evabits/EMI_sniffer_beursgadget_WOTS_2026/README.md

Here you will find the complete source documentation of the EMI sniffer after WOTS2026.
