evabits/EMI_sniffer_beursgadget_WOTS_2026/Design/EMIsniffer.kicad_pcb

## KiCad design Design/EMIsniffer.kicad_pcb (2026-09-25)

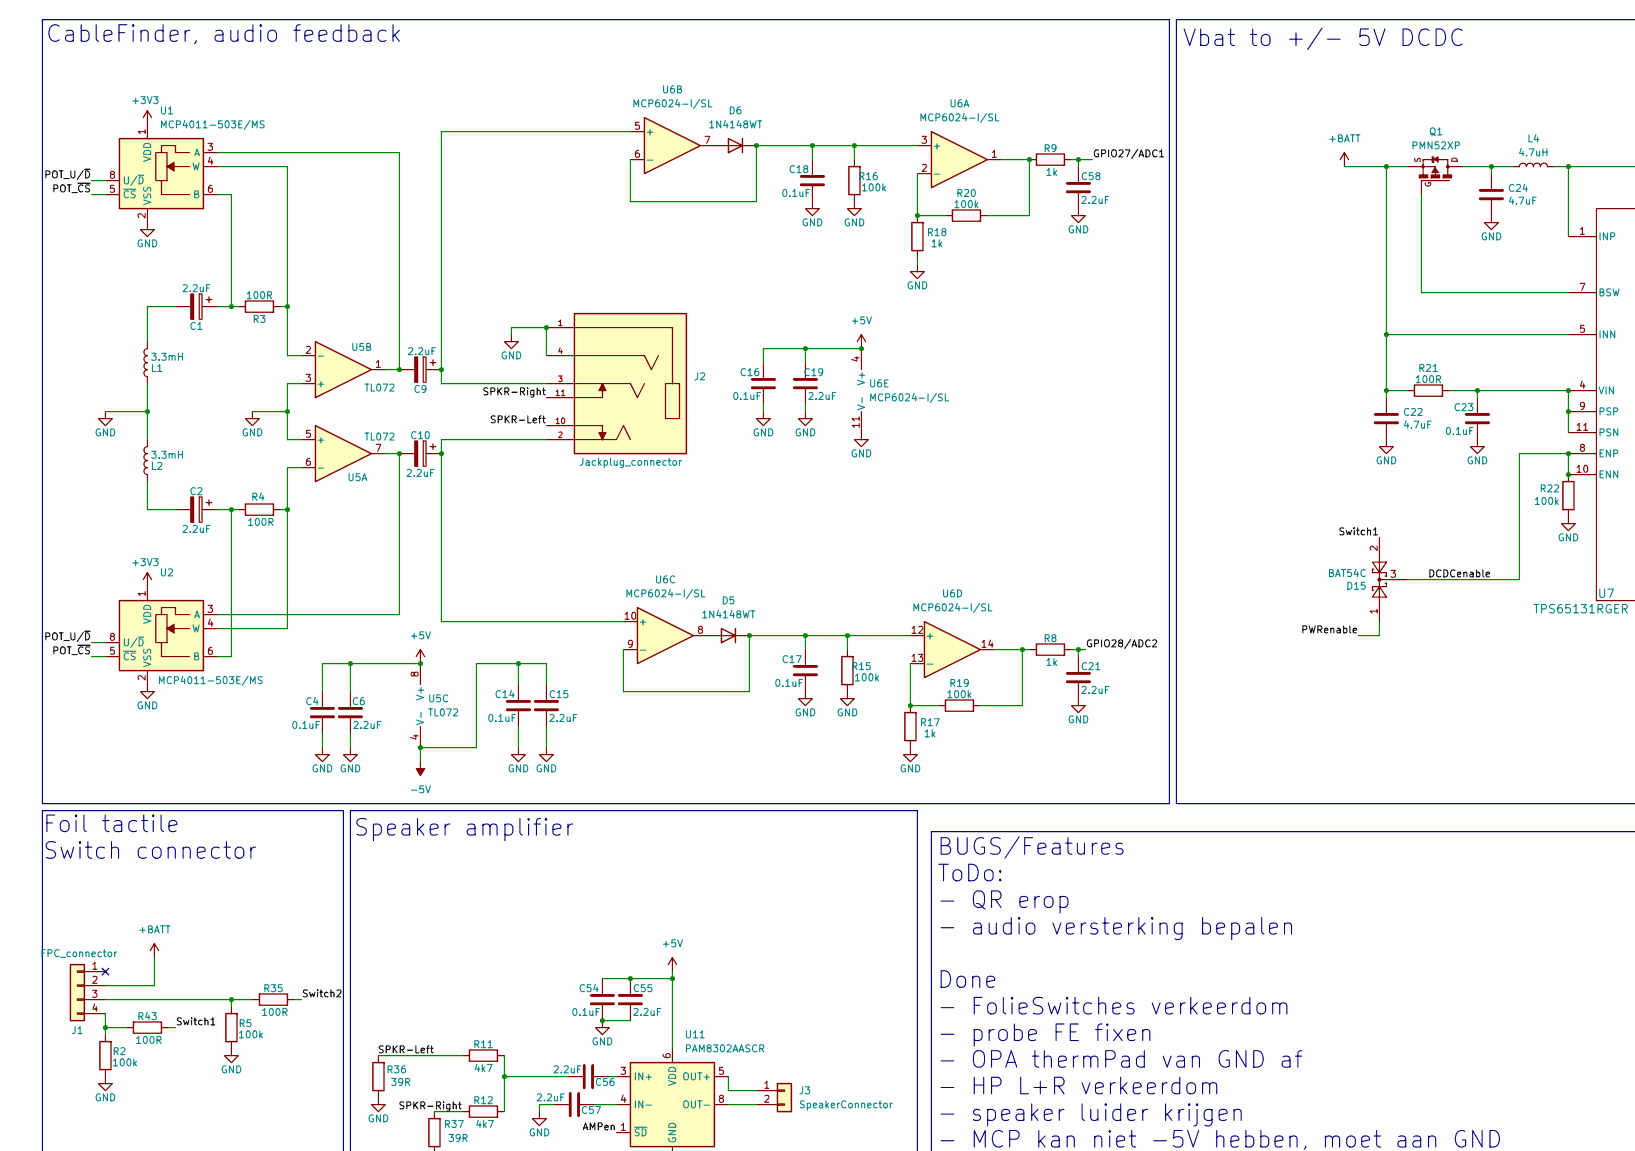
[picture p1: schematic EMIsniffer.kicad_sch, EMIsniffer (WoTS gadget 2026), part in row 1, column 1]

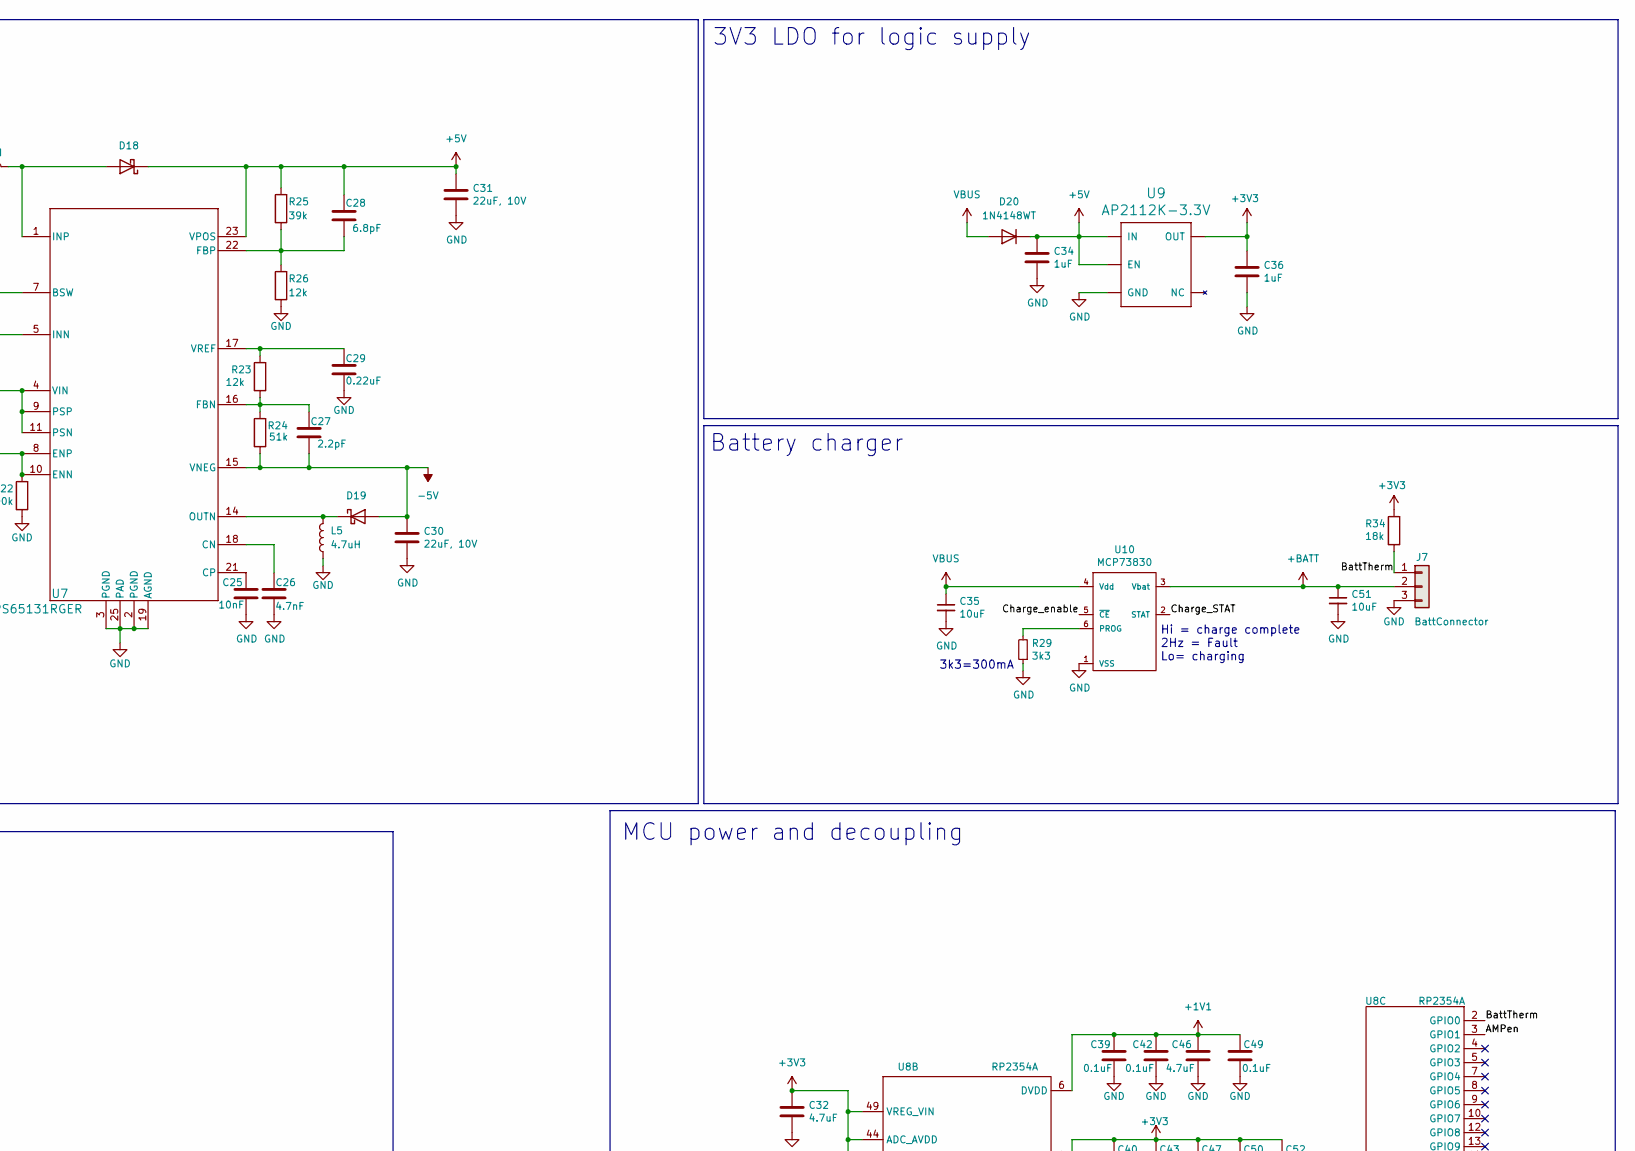
[picture p2: schematic EMIsniffer.kicad_sch, EMIsniffer (WoTS gadget 2026), part in row 1, column 2]

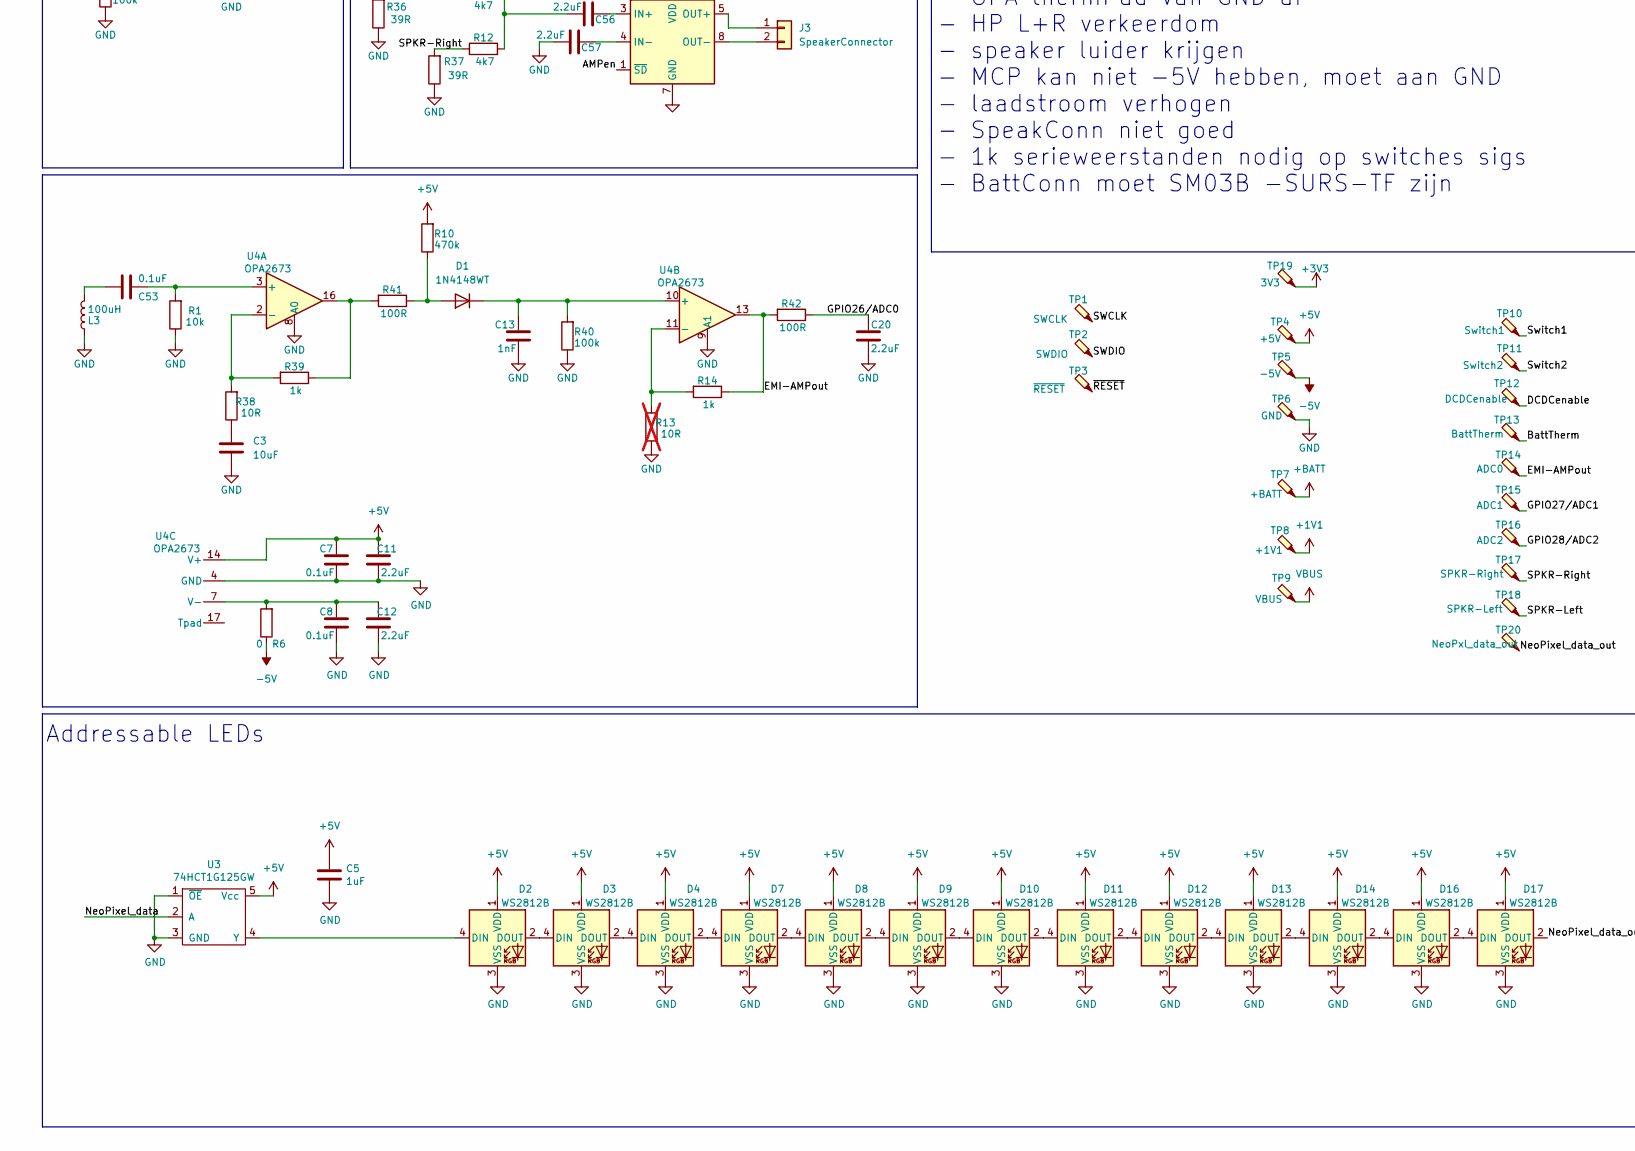
[picture p3: schematic EMIsniffer.kicad_sch, EMIsniffer (WoTS gadget 2026), part in row 2, column 1]

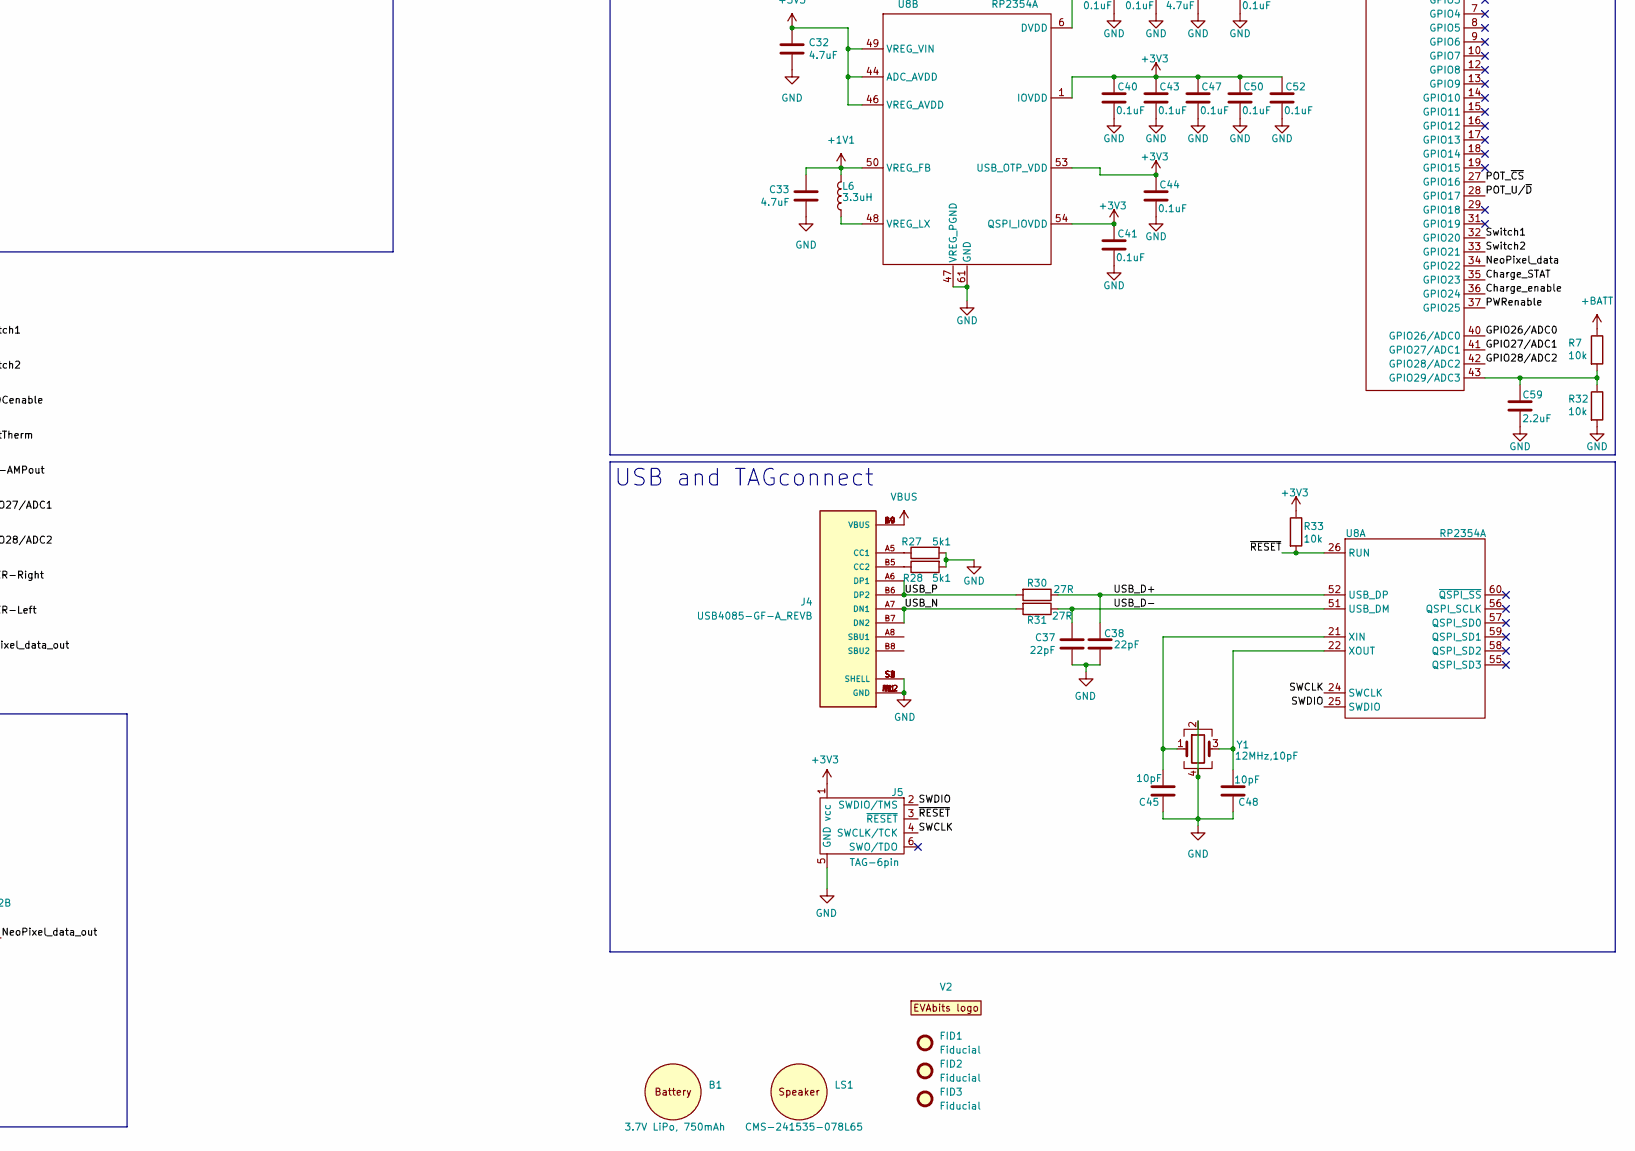
[picture p4: schematic EMIsniffer.kicad_sch, EMIsniffer (WoTS gadget 2026), part in row 2, column 2]

Parts:
B1: 3.7V LiPo, 750mAh; place_marker; Partnumber DJ343650
C1, C2, C9, C10: 2.2uF; C_Elec_4x5.4; Partnumber 865090540001
C3, C35, C51: 10uF; C_0805_2012Metric
C4, C7, C8, C14, C16, C17, C18, C23, C39, C40, C41, C42, C43, C44, C47, C49, C50, C52, C53, C54: 0.1uF; C_0402_1005Metric
C5, C34, C36: 1uF; C_0603_1608Metric
C6, C11, C12, C15, C19, C20, C21, C55, C56, C57, C58, C59: 2.2uF; C_0603_1608Metric
C13: 1nF; C_0402_1005Metric
C22, C24, C32, C33, C46: 4.7uF; C_0603_1608Metric
C25: 10nF; C_0402_1005Metric
C26: 4.7nF; C_0402_1005Metric
C27: 2.2pF; C_0402_1005Metric
C28: 6.8pF; C_0402_1005Metric
C29: 0.22uF; C_0402_1005Metric
C30, C31: 22uF, 10V; C_1206_3216Metric
C37, C38: 22pF; C_0402_1005Metric
C45, C48: 10pF; C_0402_1005Metric
D1, D5, D6, D20: 1N4148WT; D_SOD-523; Partnumber 1N4148WT
D2, D3, D4, D7, D8, D9, D10, D11, D12, D13, D14, D16, D17: WS2812B; LED_WS2812B_PLCC4_5.0x5.0mm_P3.2mm; Partnumber 1315050930002
D15: BAT54C; SOT-23; Partnumber BAT54C
D18, D19: SK12; D_SMA; Partnumber SK12
FID1, FID2, FID3: Fiducial; Fiducial_1.5mm_Mask3mm
J1: FPC_connector; TE_84952-4_1x04-1MP_P1.0mm_Horizontal; Partnumber TE_84952-4
J2: Jackplug_connector; CUI_SJ2-35954D-SMT-TR; PARTREV 1.04
J3: SpeakerConnector; Molex_PicoBlade_53398-0271_1x02-1MP_P1.25mm_Vertical; Partnumber 0533980271
J4: USB4085-GF-A_REVB; GCT_USB4085-GF-A_REVB; PARTREV B
J5: TAG-6pin; Tag-Connect_TC2030-IDC-NL_2x03_P1.27mm_Vertical; Partnumber DNP
J7: BattConnector; JST_SUR_SM03B-SURS-TF_1x03-1MP_P0.80mm_Horizontal; Partnumber SM03B -SURS-TF
L1, L2: 3.3mH; L_Wurth_WE-TI-8095; Partnumber 7447720332
L3: 100uH; IND_LQH2HNH_03_MUR; Partnumber LQH2HNH101J03L
L4, L5: 4.7uH; L_Taiyo-Yuden_NR-40xx_HandSoldering; Partnumber NRS4018T4R7MDGJ
L6: 3.3uH; L_Wuerth_PMCI-201610; Partnumber AOTA-B201610S3R3-101-T
LS1: CMS-241535-078L65; place_marker; Partnumber CMS-241535-078L65
Q1: PMN52XP; TSOP-6_1.65x3.05mm_P0.95mm; Partnumber PMN52XP
R1, R7, R32, R33: 10k; R_0603_1608Metric
R2, R5, R15, R16, R19, R20, R22, R40: 100k; R_0603_1608Metric
R3, R4, R21, R35, R41, R42, R43: 100R; R_0603_1608Metric
R6: 0; R_0603_1608Metric
R8, R9, R14, R17, R18, R39: 1k; R_0603_1608Metric
R10: 470k; R_0603_1608Metric
R11, R12: 4k7; R_0603_1608Metric
R13: 10R; R_0603_1608Metric; not fitted
R23, R26: 12k; R_0603_1608Metric
R24: 51k; R_0603_1608Metric
R25: 39k; R_0603_1608Metric
R27, R28: 5k1; R_0603_1608Metric
R29: 3k3; R_0603_1608Metric
R30, R31: 27R; R_0603_1608Metric
R34: 18k; R_0603_1608Metric
R36, R37: 39R; R_0603_1608Metric
R38: 10R; R_0603_1608Metric
TP1: SWCLK; TestPoint_Pad_D1.5mm; Partnumber DNP
TP2: SWDIO; TestPoint_Pad_D1.5mm; Partnumber DNP
TP3: ~{RESET}; TestPoint_Pad_D1.5mm; Partnumber DNP
TP4: +5V; TestPoint_Pad_D1.5mm; Partnumber DNP
TP5: -5V; TestPoint_Pad_D1.5mm; Partnumber DNP
TP6: GND; TestPoint_Pad_D1.5mm; Partnumber DNP
TP7: +BATT; TestPoint_Pad_D1.5mm; Partnumber DNP
TP8: +1V1; TestPoint_Pad_D1.5mm; Partnumber DNP
TP9: VBUS; TestPoint_Pad_D1.5mm; Partnumber DNP
TP10: Switch1; TestPoint_Pad_D1.5mm; Partnumber DNP
TP11: Switch2; TestPoint_Pad_D1.5mm; Partnumber DNP
TP12: DCDCenable; TestPoint_Pad_D1.5mm; Partnumber DNP
TP13: BattTherm; TestPoint_Pad_D1.5mm; Partnumber DNP
TP14: ADC0; TestPoint_Pad_D1.5mm; Partnumber DNP
TP15: ADC1; TestPoint_Pad_D1.5mm; Partnumber DNP
TP16: ADC2; TestPoint_Pad_D1.5mm; Partnumber DNP
TP17: SPKR-Right; TestPoint_Pad_D1.5mm; Partnumber DNP
TP18: SPKR-Left; TestPoint_Pad_D1.5mm; Partnumber DNP
TP19: 3V3; TestPoint_Pad_D1.5mm; Partnumber DNP
TP20: NeoPxl_data_out; TestPoint_Pad_D1.5mm; Partnumber DNP
U1, U2: MCP4011-503E/MS; MSOP-8_3x3mm_P0.65mm; Partnumber MCP4011-503E/MS
U3: 74HCT1G125GW; SOT-353_SC-70-5; Partnumber 74HCT1G125GW
U4: OPA2673; QFN-16-1EP_4x4mm_P0.65mm_EP2.1x2.1mm; Partnumber OPA2673IRGVR
U5: TL072; SO-8_3.9x4.9mm_P1.27mm; Partnumber TL072
U6: MCP6024-I/SL; SOIC-14_3.9x8.7mm_P1.27mm; Partnumber MCP6024-I/SL
U7: TPS65131RGER; VQFN-24-1EP_4x4mm_P0.5mm_EP2.5x2.5mm; Partnumber TPS65131-Q1
U8: RP2354A; QFN-60-1EP_7x7mm_P0.4mm_EP3.4x3.4mm; Partnumber RP2354A
U9: AP2112K-3.3V; TSOT-23-5; Partnumber AP2112K-3.3
U10: MCP73830; DFN-6-1EP_2x2mm_P0.5mm_EP0.61x1.42mm; Partnumber MCP73830T-2AAI/MYY
U11: PAM8302AASCR; MSOP-8_3x3mm_P0.65mm; Partnumber PAM8302AASCR
V2: EVAbits_logo; EVAbits_newlogo 25x6mm
Y1: 12MHz,10pF; Crystal_SMD_3225-4Pin_3.2x2.5mm; Partnumber NX3225SA-12MHZ-STD-CSR-6

Connections:
+1V1: C33.2, C39.1, C42.1, C46.2, C49.1, L6.1, TP8.1, U8.6 (DVDD), U8.23 (DVDD), U8.39 (DVDD), U8.50 (VREG_FB)
+3V3: C32.2, C36.2, C40.1, C41.1, C43.1, C44.1, C47.1, C50.1, C52.1, J5.1 (vcc), R33.1, R34.1, TP19.1, U1.1 (VDD), U2.1 (VDD), U8.1 (IOVDD), U8.11 (IOVDD), U8.20 (IOVDD), U8.30 (IOVDD), U8.38 (IOVDD), U8.44 (ADC_AVDD), U8.45 (IOVDD), U8.46 (VREG_AVDD), U8.49 (VREG_VIN), U8.53 (USB_OTP_VDD), U8.54 (QSPI_IOVDD), U9.5 (OUT)
+5V: C4.1, C5.2, C6.2, C7.1, C11.2, C16.1, C19.2, C28.1, C31.2, C34.2, C54.1, C55.2, D2.1 (VDD), D3.1 (VDD), D4.1 (VDD), D7.1 (VDD), D8.1 (VDD), D9.1 (VDD), D10.1 (VDD), D11.1 (VDD), D12.1 (VDD), D13.1 (VDD), D14.1 (VDD), D16.1 (VDD), D17.1 (VDD), D18.1 (K), D20.1 (K), R10.2, R25.1, TP4.1, U3.5 (Vcc), U4.14 (V+), U5.8 (V+), U6.4 (V+), U7.23 (VPOS), U9.1 (IN), U9.3 (EN), U11.6 (VDD)
+BATT: C22.2, C51.1, J1.2, J7.2, Q1.4 (S), R7.1, R21.1, TP7.1, U7.5 (INN), U7.6 (INN), U10.3 (Vbat)
-5V: C14.1, C15.2, C27.2, C30.2, D19.2 (A), R6.1, R24.2, TP5.1, U5.4 (V-), U7.15 (VNEG)
/AMPen: U8.3 (GPIO1), U11.1 (~SD)
/BattTherm: J7.1, R34.2, TP13.1, U8.2 (GPIO0)
/Charge_STAT: U8.35 (GPIO23), U10.2 (STAT)
/Charge_enable: U8.36 (GPIO24), U10.5 (~CE)
/DCDCenable: D15.3, R22.1, TP12.1, U7.8 (ENP), U7.10 (ENN)
/EMI-AMPout: R14.1, R42.2, TP14.1, U4.13
/GPIO26/ADC0: C20.2, R42.1, U8.40 (GPIO26/ADC0)
/GPIO27/ADC1: C58.2, R9.2, TP15.1, U8.41 (GPIO27/ADC1)
/GPIO28/ADC2: C21.2, R8.2, TP16.1, U8.42 (GPIO28/ADC2)
/NeoPixel_data: U3.2 (A), U8.34 (GPIO22)
/NeoPixel_data_out: D17.2 (DOUT), TP20.1
/POT_U/~D: U1.8 (U/~D), U2.8 (U/~D), U8.28 (GPIO17)
/POT_~CS: U1.5 (~CS), U2.5 (~CS), U8.27 (GPIO16)
/PWRenable: D15.1, U8.37 (GPIO25)
/SPKR-Left: J2.10, R11.1, R36.2, TP18.1
/SPKR-Right: J2.11, R12.1, R37.2, TP17.1
/SWCLK: J5.4 (SWCLK/TCK), TP1.1, U8.24 (SWCLK)
/SWDIO: J5.2 (SWDIO/TMS), TP2.1, U8.25 (SWDIO)
/Switch1: D15.2, R43.1, TP10.1, U8.32 (GPIO20)
/Switch2: R35.1, TP11.1, U8.33 (GPIO21)
/USB_D+: C38.2, R30.1, U8.52 (USB_DP)
/USB_D-: C37.1, R31.1, U8.51 (USB_DM)
/USB_N: J4.A7 (DN1), J4.B7 (DN2), R31.2
/USB_P: J4.A6 (DP1), J4.B6 (DP2), R30.2
/~RESET: J5.3 (~RESET), R33.2, TP3.1, U8.26 (RUN)
GND: C3.2, C4.2, C5.1, C6.1, C7.2, C8.2, C11.1, C12.1, C13.2, C14.2, C15.1, C16.2, C17.2, C18.2, C19.1, C20.1, C21.1, C22.1, C23.2, C24.1, C25.2, C26.2, C29.2, C30.1, C31.1, C32.1, C33.1, C34.1, C35.2, C36.1, C37.2, C38.1, C39.2, C40.2, C41.2, C42.2, C43.2, C44.2, C45.2, C46.1, C47.2, C48.1, C49.2, C50.2, C51.2, C52.2, C54.2, C55.1, C57.2, C58.1, C59.1, D2.3 (VSS), D3.3 (VSS), D4.3 (VSS), D7.3 (VSS), D8.3 (VSS), D9.3 (VSS), D10.3 (VSS), D11.3 (VSS), D12.3 (VSS), D13.3 (VSS), D14.3 (VSS), D16.3 (VSS), D17.3 (VSS), J2.1, J2.4, J4.A1 (GND), J4.A12 (GND), J4.B1 (GND), J4.B12 (GND), J4.S1 (SHELL), J4.S2 (SHELL), J4.S3 (SHELL), J4.S4 (SHELL), J5.5 (GND), J7.3, L1.1, L2.2, L3.1, L5.1, R1.1, R2.1, R5.1, R13.1, R15.1, R16.1, R17.1, R18.1, R22.2, R26.2, R27.2, R28.2, R29.1, R32.2, R36.1, R37.1, R40.1, TP6.1, U1.2 (VSS), U2.2 (VSS), U3.1 (~OE), U3.3 (GND), U4.1 (GND), U4.4 (GND), U4.5 (GND), U4.6 (GND), U4.8 (A0), U4.9 (A1), U4.12 (GND), U4.15 (GND), U5.3 (+), U5.5 (+), U6.11 (V-), U7.2 (PGND), U7.3 (PGND), U7.19 (AGND), U7.25 (PAD), U8.47 (VREG_PGND), U8.61 (GND), U9.2 (GND), U10.1 (VSS), U10.7 (VSS), U11.7 (GND), Y1.2, Y1.4
INP: D18.2 (A), L4.2, U7.1 (INP), U7.24 (INP)
unnamed: C1.2, L1.2
unnamed: C2.2, L2.1
unnamed: C3.1, R38.1
unnamed: C24.2, L4.1, Q1.1 (D), Q1.2 (D), Q1.5 (D), Q1.6 (D)
unnamed: C53.1, L3.2
unnamed: C56.2, R11.2, R12.2
unnamed: D1.2 (A), R10.1, R41.1
unnamed: C13.1, D1.1 (K), R40.2, U4.10 (+)
unnamed: D2.4 (DIN), U3.4 (Y)
unnamed: D2.2 (DOUT), D3.4 (DIN)
unnamed: D3.2 (DOUT), D4.4 (DIN)
unnamed: D4.2 (DOUT), D7.4 (DIN)
unnamed: D5.2 (A), U6.8
unnamed: C17.1, D5.1 (K), R15.2, U6.9 (-), U6.12 (+)
unnamed: D6.2 (A), U6.7
unnamed: C18.1, D6.1 (K), R16.2, U6.3 (+), U6.6 (-)
unnamed: D7.2 (DOUT), D8.4 (DIN)
unnamed: D8.2 (DOUT), D9.4 (DIN)
unnamed: D9.2 (DOUT), D10.4 (DIN)
unnamed: D10.2 (DOUT), D11.4 (DIN)
unnamed: D11.2 (DOUT), D12.4 (DIN)
unnamed: D12.2 (DOUT), D13.4 (DIN)
unnamed: D13.2 (DOUT), D14.4 (DIN)
unnamed: D14.2 (DOUT), D16.4 (DIN)
unnamed: D16.2 (DOUT), D17.4 (DIN)
unnamed: J1.3, R5.2, R35.2
unnamed: J1.4, R2.2, R43.2
unnamed: J3.1, U11.5 (OUT+)
unnamed: J3.2, U11.8 (OUT-)
unnamed: J4.A5 (CC1), R27.1
unnamed: J4.B5 (CC2), R28.1
unnamed: Q1.3 (G), U7.7 (BSW)
unnamed: R8.1, R19.2, U6.14
unnamed: R9.1, R20.2, U6.1
unnamed: R39.1, R41.2, U4.16
unnamed: C9.2, U1.3 (A), U5.1
unnamed: C1.1, R3.1, U1.6 (B)
unnamed: R3.2, U1.4 (W), U5.2 (-)
unnamed: C10.2, U2.3 (A), U5.7
unnamed: C2.1, R4.1, U2.6 (B)
unnamed: R4.2, U2.4 (W), U5.6 (-)
unnamed: C53.2, R1.2, U4.3 (+)
unnamed: R38.2, R39.2, U4.2 (-)
unnamed: R13.2, R14.2, U4.11 (-)
unnamed: C8.1, C12.2, R6.2, U4.7 (V-)
unnamed: R18.2, R20.1, U6.2 (-)
unnamed: C9.1, J2.3, U6.5 (+)
unnamed: C10.1, J2.2, U6.10 (+)
unnamed: R17.2, R19.1, U6.13 (-)
unnamed: C26.1, U7.18 (CN)
unnamed: C25.1, U7.21 (CP)
unnamed: C27.1, R23.2, R24.1, U7.16 (FBN)
unnamed: C28.2, R25.2, R26.1, U7.22 (FBP)
unnamed: C23.1, R21.2, U7.4 (VIN), U7.9 (PSP), U7.11 (PSN)
unnamed: C29.1, R23.1, U7.17 (VREF)
unnamed: C45.1, U8.21 (XIN), Y1.1
unnamed: C48.2, U8.22 (XOUT), Y1.3
unnamed: L6.2, U8.48 (VREG_LX)
unnamed: C59.2, R7.2, R32.1, U8.43 (GPIO29/ADC3)
unnamed: R29.2, U10.6 (PROG)
unnamed: C56.1, U11.3 (IN+)
unnamed: C57.1, U11.4 (IN-)
OUTN: D19.1 (K), L5.2, U7.13 (OUTN), U7.14 (OUTN)
VBUS: C35.1, D20.2 (A), J4.A4 (VBUS), J4.A9 (VBUS), J4.B4 (VBUS), J4.B9 (VBUS), TP9.1, U10.4 (Vdd)

Notes on the sheet:
Speaker amplifier
3k3=300mA
USB and TAGconnect
Hi = charge complete 2Hz = Fault Lo= charging
MCU power and decoupling
CableFinder, audio feedback
3V3 LDO for logic supply
Addressable LEDs
Vbat to +/- 5V DCDC
Foil tactile Switch connector
Battery charger
BUGS/Features ToDo: - QR erop - audio versterking bepalen Done - FolieSwitches verkeerdom - probe FE fixen - OPA thermPad van GND af - HP L+R verkeerdom - speaker luider krijgen - MCP kan niet -5V hebben, moet aan GND - laadstroom verhogen - SpeakConn niet goed - 1k serieweerstanden nodig op switch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

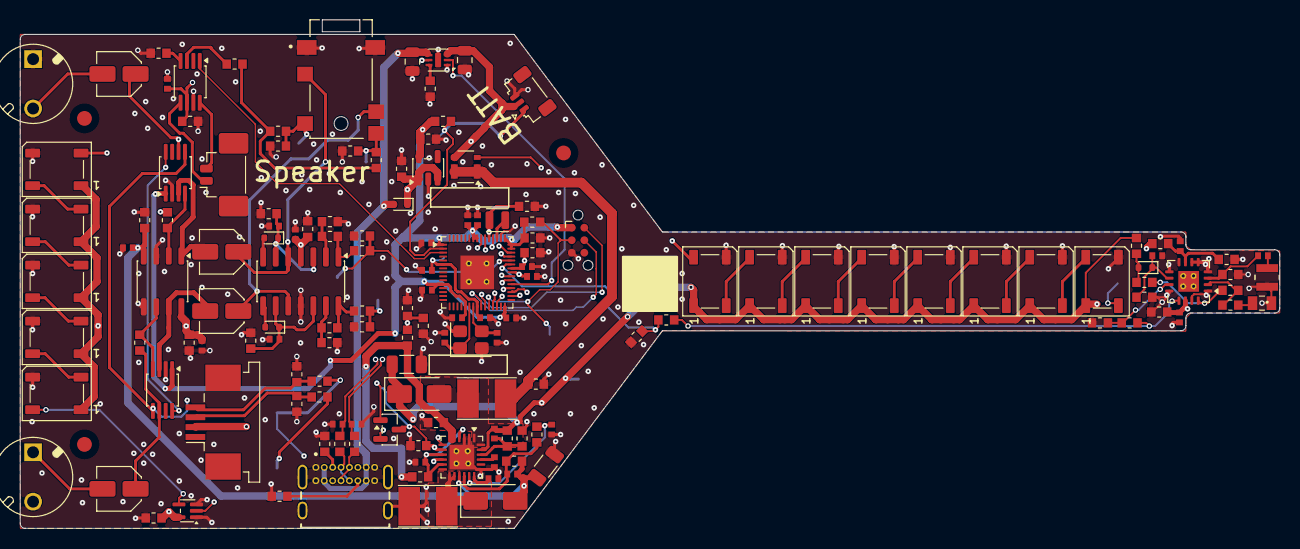
[picture p5: board EMIsniffer.kicad_pcb from above]

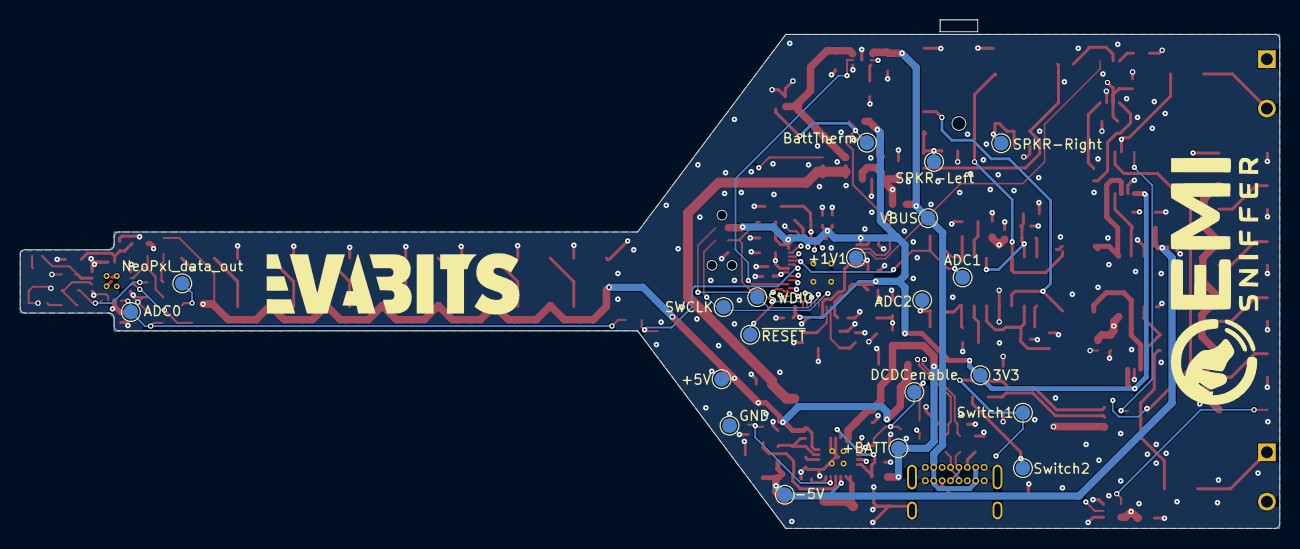
[picture p6: board EMIsniffer.kicad_pcb from below]

Board: 4 copper layers, 127.5 x 51.5 mm, 173 parts (22 on the bottom side), 96 nets.
